DulajBopitiya/Nemesis-Micro-mouse-/Nemisis Firmware/Core/Src/main.c

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
/* Includes ------------------------------------------------------------------*/
#include "main.h"

/* USER CODE BEGIN Includes */
#include "ws2812.h"
#include "buzzer.h"
#include "dbg.h"
#include "icm42688.h"
#include "max17049.h"
#include "motor.h"
#include "as5047p.h"
#include "battery.h"
#include "console.h"
#include "sensors.h"
#include "launcher.h"
#include "control.h"
#include "solver.h"
#include "mazestore.h"
/* USER CODE END Includes */

ADC_HandleTypeDef hadc1;
ADC_HandleTypeDef hadc4;

I2C_HandleTypeDef hi2c3;

QSPI_HandleTypeDef hqspi1;

SPI_HandleTypeDef hspi1;
SPI_HandleTypeDef hspi3;

TIM_HandleTypeDef htim1;
TIM_HandleTypeDef htim2;
TIM_HandleTypeDef htim3;
TIM_HandleTypeDef htim8;
TIM_HandleTypeDef htim15;
DMA_HandleTypeDef hdma_tim15_ch1;

UART_HandleTypeDef huart1;

void SystemClock_Config(void);
static void MX_GPIO_Init(void);
static void MX_DMA_Init(void);
static void MX_TIM15_Init(void);
static void MX_SPI1_Init(void);
static void MX_I2C3_Init(void);
static void MX_ADC4_Init(void);
static void MX_SPI3_Init(void);
static void MX_TIM1_Init(void);
static void MX_TIM2_Init(void);
static void MX_ADC1_Init(void);
static void MX_TIM8_Init(void);
static void MX_USART1_UART_Init(void);
static void MX_TIM3_Init(void);
static void MX_QUADSPI1_Init(void);
/* USER CODE BEGIN 0 */

/* ====================== IR reflectance sensors ========================
   6 emitter/receiver pairs. Naming: side (LEFT/RIGHT) + position
   (LM = left-most, M = middle, FRONT). Emitters are GPIO outputs that drive
   an IR LED through a MOSFET (active-HIGH). Receivers are phototransistors
   read by an ADC.

   Receiver -> ADC mapping (from main.h pins / CubeMX MSP comments):
     RIGHT_RM    PB12 -> ADC4_IN3   (hadc4)
     LEFT_LM     PA0  -> ADC1_IN1   \
     RIGHT_M     PA3  -> ADC1_IN4    |
     RIGHT_FRONT PC1  -> ADC1_IN7    >  ADC1 (hadc1), configured in CubeMX
     LEFT_FRONT  PC2  -> ADC1_IN8    |
     LEFT_M      PC3  -> ADC1_IN9   /
   ====================================================================== */

#define IR_AVG_SAMPLES  16U     /* conversions averaged per phase (noise floor) */

/* Average N single conversions of one channel on the given ADC. Reconfigures
   the channel each call so one ADC can be shared across several inputs. */
static uint16_t ADC_ReadAvg(ADC_HandleTypeDef *adc, uint32_t channel, uint32_t n)
{
  ADC_ChannelConfTypeDef c = {0};
  c.Channel      = channel;
  c.Rank         = ADC_REGULAR_RANK_1;
  c.SamplingTime = ADC_SAMPLETIME_640CYCLES_5;  /* high-Z phototransistor node */
  c.SingleDiff   = ADC_SINGLE_ENDED;
  c.OffsetNumber = ADC_OFFSET_NONE;
  c.Offset       = 0;
  HAL_ADC_ConfigChannel(adc, &c);

  uint32_t acc = 0;
  for (uint32_t i = 0; i < n; i++)
  {
    HAL_ADC_Start(adc);
    HAL_ADC_PollForConversion(adc, 10);
    acc += HAL_ADC_GetValue(adc);
    HAL_ADC_Stop(adc);
  }
  return (uint16_t)(acc / n);
}

/* One IR sensor: its emitter GPIO + the ADC + channel its receiver sits on. */
typedef struct
{
  const char        *name;
  GPIO_TypeDef      *em_port;
  uint16_t           em_pin;
  ADC_HandleTypeDef *adc;
  uint32_t           channel;
} IR_Sensor;

#define IR_COUNT 6
static const IR_Sensor ir_sensors[IR_COUNT] =
{
  { "L_LM", LEFT_LM_EMMITER_GPIO_Port,     LEFT_LM_EMMITER_Pin,     &hadc1, ADC_CHANNEL_1 }, /* recv PA0=ADC1_IN1 */
  { "L_M",  LEFT_M_EMMITER_GPIO_Port,      LEFT_M_EMMITER_Pin,      &hadc1, ADC_CHANNEL_9 }, /* recv PC3=ADC1_IN9 */
  { "L_F",  LEFT_FRONT_EMMITER_GPIO_Port,  LEFT_FRONT_EMMITER_Pin,  &hadc1, ADC_CHANNEL_8 }, /* recv PC2=ADC1_IN8 */
  { "R_F",  RIGHT_FRONT_EMMITER_GPIO_Port, RIGHT_FRONT_EMMITER_Pin, &hadc1, ADC_CHANNEL_7 }, /* recv PC1=ADC1_IN7 */
  { "R_M",  RIGHT_M_EMMITER_GPIO_Port,     RIGHT_M_EMMITER_Pin,     &hadc1, ADC_CHANNEL_4 }, /* recv PA3=ADC1_IN4 */
  { "R_RM", RIGHT_RM_EMMITER_GPIO_Port,    RIGHT_RM_EMMITER_Pin,    &hadc4,    ADC_CHANNEL_3 }, /* recv PB12=ADC4_IN3 */
};

/* Reflective read of one sensor: emitter OFF (ambient) then ON (ambient + IR);
   reflected = lit - ambient. Only one emitter is ever on at a time, so there's
   no optical crosstalk between sensors. Emitter assumed active-HIGH. */
static void IR_Read(const IR_Sensor *s, uint16_t *amb, uint16_t *lit)
{
  HAL_GPIO_WritePin(s->em_port, s->em_pin, GPIO_PIN_RESET);
  HAL_Delay(1);
  *amb = ADC_ReadAvg(s->adc, s->channel, IR_AVG_SAMPLES);

  HAL_GPIO_WritePin(s->em_port, s->em_pin, GPIO_PIN_SET);
  HAL_Delay(1);                                   /* let LED + receiver settle */
  *lit = ADC_ReadAvg(s->adc, s->channel, IR_AVG_SAMPLES);

  HAL_GPIO_WritePin(s->em_port, s->em_pin, GPIO_PIN_RESET);
}

/* USER CODE END 0 */

/**
  * @brief  The application entry point.
  * @retval int
  */
int main(void)
{

  /* USER CODE BEGIN 1 */
#ifdef APP_VTOR_BASE
  /* OTA-relocated build (env:app_ota): the app lives at 0x08008000, reached via
     the bootloader. Point the vector table at the app base HERE, before HAL_Init
     enables SysTick or any IRQ - unambiguous and independent of the framework's
     fragile VECT_TAB_OFFSET macro. (The bootloader also sets VTOR before the
     jump; this makes the app self-correct regardless of how it was entered.) */
  SCB->VTOR = (uint32_t)(APP_VTOR_BASE);
#endif
  uint32_t last_led = 0;     /* heartbeat LED scheduler */
  uint8_t  led_step = 0;
  uint32_t last_sens = 0;    /* IR sensor sweep scheduler (~100 Hz) */
  /* USER CODE END 1 */

  /* MCU Configuration--------------------------------------------------------*/

  /* Reset of all peripherals, Initializes the Flash interface and the Systick. */
  HAL_Init();

  /* Configure the system clock */
  SystemClock_Config();

  /* Initialize all configured peripherals */
  MX_GPIO_Init();
  MX_DMA_Init();
  MX_TIM15_Init();
  MX_SPI1_Init();
  MX_I2C3_Init();
  MX_ADC4_Init();
  MX_SPI3_Init();
  MX_TIM1_Init();
  MX_TIM2_Init();
  MX_ADC1_Init();
  MX_TIM8_Init();
  MX_USART1_UART_Init();
  MX_TIM3_Init();
  MX_QUADSPI1_Init();
  /* USER CODE BEGIN 2 */
  DBG_Init();
  LOG("\r\n=== Nemisis boot ===\r\n");
  LOG("build: " __DATE__ " " __TIME__ "\r\n");   /* prove which binary is running */

  /* --- Persistent maze / speed-run memory (internal flash) --------------
     Reads the reset cause FIRST (before anything clears the flags): a cold
     power-on / battery swap KEEPS the last saved run, a warm NRST-button reset
     ERASES it. Then loads any saved map so a long-press fast run is available
     after a power cycle. Must run before the launcher/solver use the map. */
  MazeStore_Init();

  /* Recompute SystemCoreClock straight from the RCC registers, then dump the
     actual PLL config so we can see what the silicon is really doing. */
  SystemCoreClockUpdate();
  LOG("SYSCLK = %lu Hz  (HSE_VALUE=%lu)\r\n",
      (unsigned long)SystemCoreClock, (unsigned long)HSE_VALUE);
  LOG("PLLCFGR=0x%08lX  PLLM=%lu PLLN=%lu PLLR=%lu\r\n",
      (unsigned long)RCC->PLLCFGR,
      (unsigned long)(((RCC->PLLCFGR & RCC_PLLCFGR_PLLM) >> RCC_PLLCFGR_PLLM_Pos) + 1U),
      (unsigned long)((RCC->PLLCFGR & RCC_PLLCFGR_PLLN) >> RCC_PLLCFGR_PLLN_Pos),
      (unsigned long)((((RCC->PLLCFGR & RCC_PLLCFGR_PLLR) >> RCC_PLLCFGR_PLLR_Pos) + 1U) * 2U));
  LOG("CR=0x%08lX  HSERDY=%lu PLLRDY=%lu  CFGR_SWS=%lu (3=PLL)\r\n",
      (unsigned long)RCC->CR,
      (unsigned long)((RCC->CR & RCC_CR_HSERDY) ? 1U : 0U),
      (unsigned long)((RCC->CR & RCC_CR_PLLRDY) ? 1U : 0U),
      (unsigned long)((RCC->CFGR & RCC_CFGR_SWS) >> RCC_CFGR_SWS_Pos));

  Buzzer_Init();
  WS2812_Init(&htim15, TIM_CHANNEL_1);

  /* cool power-on chime */
  Buzzer_StartupSound();

  /* --- ICM-42688-P IMU bring-up check (SPI1) ---------------------------- */
  bool imu_ok = ICM42688_Init(&hspi1);       /* soft reset + WHO_AM_I + power on */
  uint8_t imu_who = ICM42688_ReadReg(&hspi1, 0x75);  /* read it back for the log */
  LOG("IMU WHO_AM_I = 0x%02X (expect 0x%02X) -> %s\r\n",
      imu_who, ICM42688_WHOAMI,
      imu_ok ? "OK" : "FAILED (check wiring/CS/SPI cfg)");

  /* --- I2C3 bus scan (diagnostic): list every 7-bit address that ACKs --- */
  LOG("I2C3 scan:");
  uint8_t found = 0;
  for (uint8_t a = 1; a < 128; a++)
  {
    if (HAL_I2C_IsDeviceReady(&hi2c3, (uint16_t)(a << 1), 2, 5) == HAL_OK)
    {
      LOG(" 0x%02X", a);
      found++;
    }
  }
  LOG("  (%u device(s))\r\n", found);

  /* --- MAX17049 fuel gauge bring-up check (I2C3) ------------------------ */
  bool fuel_ok = MAX17049_Probe(&hi2c3);
  if (fuel_ok)
  {
    MAX17049_Status s;
    MAX17049_ReadStatus(&hi2c3, &s);
    LOG("FUEL ver=0x%04X  pack=%ld mV  soc=%ld.%02ld %%  rate=%ld m%%/hr -> OK\r\n",
        s.version, (long)(s.pack_v * 1000.0f),
        (long)s.soc, (long)((s.soc - (long)s.soc) * 100.0f),
        (long)(s.crate * 1000.0f));
  }
  else
  {
    LOG("FUEL gauge: NO ACK (check I2C3 wiring / pull-ups / battery)\r\n");
  }

  /* --- AS5047P encoders bring-up check (shared SPI3, separate CS) -------
     Both encoders sit on SPI3; left CS=PA4, right CS=PB2. Each read pulses
     only its own CS, so they coexist on the one bus. */
  AS5047P_Handle encL, encR;
  AS5047P_Init(&encL, &hspi3, ENCODERL_CS_GPIO_Port, ENCODERL_CS_Pin);
  AS5047P_Init(&encR, &hspi3, ENCODERR_CS_GPIO_Port, ENCODERR_CS_Pin);
  bool encL_ok = AS5047P_Probe(&encL);
  bool encR_ok = AS5047P_Probe(&encR);
  LOG("ENCODERL raw=%u -> %s\r\n", AS5047P_ReadAngleRaw(&encL),
      encL_ok ? "OK" : "bad frame (check CS PA4 / MISO / power)");
  LOG("ENCODERR raw=%u -> %s\r\n", AS5047P_ReadAngleRaw(&encR),
      encR_ok ? "OK" : "bad frame (check CS PB2 / MISO / power)");

  /* ABI quadrature cross-check: left A/B (PC0/PA9) -> TIM1, right A/B
     (PA1/PA5) -> TIM2. Start both counters from zero. */
  HAL_TIM_Encoder_Start(&htim1, TIM_CHANNEL_ALL);
  HAL_TIM_Encoder_Start(&htim2, TIM_CHANNEL_ALL);
  __HAL_TIM_SET_COUNTER(&htim1, 0);
  __HAL_TIM_SET_COUNTER(&htim2, 0);

  /* --- All 6 IR reflectance sensors bring-up --------------------------
     Calibrate both ADCs (ADC4 for RIGHT_RM, ADC1 for the other five), then do
     one reflective read of each. With nothing in front 'refl' is small; bring
     a hand/wall close to a given sensor and only that one's 'refl' should jump. */
  HAL_ADCEx_Calibration_Start(&hadc4, ADC_SINGLE_ENDED);
  HAL_ADCEx_Calibration_Start(&hadc1, ADC_SINGLE_ENDED);
  for (int i = 0; i < IR_COUNT; i++)
  {
    uint16_t amb, lit;
    IR_Read(&ir_sensors[i], &amb, &lit);
    int delta = (int)lit - (int)amb;
    LOG("IR %-4s: ambient=%4u lit=%4u reflected=%5d -> %s\r\n",
        ir_sensors[i].name, amb, lit, delta,
        (delta > 20 || delta < -20) ? "responding" : "weak/none (check wiring/polarity)");
  }

  /* --- Vacuum fan bring-up (PB9 = TIM8_CH3 PWM, MOSFET-driven) ----------
     TIM8 is an advanced timer, so HAL_TIM_PWM_Start also flips the main output
     enable (MOE) for us. Period=65535, so CCR = duty% * 65535 / 100. Start at
     0% (fan off) and ramp it in the loop below so you can hear/feel each step.
     WARNING: secure the robot - the fan pulls air hard at 100%. */
  HAL_TIM_PWM_Start(&htim8, TIM_CHANNEL_3);
  __HAL_TIM_SET_COMPARE(&htim8, TIM_CHANNEL_3, 0);
  LOG("VACUUM FAN on PB9 (TIM8_CH3) ready - ramping 0/25/50/75/100%% in loop\r\n");

  LOG("init done\r\n");

  /* --- DRV8874 motor movement test (M1: PC8/PC7, M2: PC6/PB7) -----------
     Runs ONCE at boot: both forward, both reverse, pivot one way, pivot the
     other, then stops. WARNING: the robot WILL drive - put it on a stand or
     in clear space first. 3 s grace delay below so you can let go. Watch RTT
     for the per-phase current sense. Set this #if to 0 once verified. */
/* Motors are now driven interactively from the console ('motor ...' /
   'motor test'); the old auto-drive-at-boot is disabled for safety. */
#if 0
  Motor_TestInit(&hadc4);
  LOG("MOTOR demo starting in 3 s - clear the bench / put on stand...\r\n");
  HAL_Delay(3000);
  Motor_DriveSequence(&hadc4);
#endif

  /* --- Interactive debug console (RTT + USART1->ESP32) ------------------
     Type 'help' over J-Link RTT Viewer (or the ESP32/WiFi link) to drive any
     subsystem on demand. This replaces the old fixed demo loop. */
  ConsoleCtx con = {
    .hspi_imu  = &hspi1,
    .hspi_enc  = &hspi3,
    .hi2c_fuel = &hi2c3,
    .hadc1     = &hadc1,
    .hadc4     = &hadc4,
    .htim_fan  = &htim8,
    .htim_mot  = &htim3,
    .htim_encL = &htim1,
    .htim_encR = &htim2,
    .huart     = &huart1,
    .hqspi     = &hqspi1,
  };
  Console_Init(&con);

  /* --- Battery safety monitor (MAX17049 on I2C3) -----------------------
     Watches pack voltage; blocks + kills motors/vacuum when CRITICAL and
     signals state on the RGB LED + buzzer. Voltage-based, not SOC-based.
     Must come after WS2812/Buzzer init and the fan PWM start. */
  Battery_Init(&hi2c3, &htim8, TIM_CHANNEL_3);
  LOG("BATTERY monitor armed (crit<%umV low<%umV) - state=%s\r\n",
      (unsigned)BATTERY_CRIT_MV, (unsigned)BATTERY_LOW_MV,
      Battery_StateName(Battery_State()));

  /* --- IR wall sensors (6x reflectance on ADC1/ADC4) -------------------
     Acquisition layer for wall detection + corridor centring. Swept from the
     main loop below (~100 Hz); ADCs are already calibrated in Console_Init. */
  Sensors_Init(&hadc1, &hadc4);
  Sensors_CalLoad();                 /* restore wall-sensor calibration from flash */
  LOG("SENSORS armed (6x IR, ~100 Hz sweep) - 'walls' to view\r\n");

  /* --- Offline race-start launcher (button PD2 + front-sensor gesture) ---
     Press the button to go fully offline (mutes the WiFi link so it can't jitter
     the loop), wave a hand over the two front sensors to arm, 3 s countdown, then
     it runs the solve with no app attached. Button again = cancel/abort. */
  Launcher_Init();
  LOG("LAUNCHER ready - press button for offline run (hand over front IR to go)\r\n");
  /* USER CODE END 2 */

  /* Infinite loop */
  /* USER CODE BEGIN WHILE */
  while (1)
  {
    /* USER CODE END WHILE */

    /* USER CODE BEGIN 3 */
    /* Non-blocking: parse any command from RTT/USART1 and stream live samples
       for whichever subsystem is active. All interactive debug lives here. */
    Console_Task();

    /* IR wall-sensor sweep at ~200 Hz (every 5 ms). Polling for now; the 1 kHz
       control loop preempts it so its timing is unaffected. (Restored to 200 Hz
       for lower centring lag now that the boot hang - a UART TX-ring deadlock,
       unrelated to the sweep rate - is fixed. ~4 mm lag at mapping speed. The
       real low-lag fix is still the DMA transport swap for the speed run - see
       the navigator-cell-motion / ir-wall-sensors notes / fast-run-dma reminder.) */
    /* Speed-adaptive IR: faster sweep (fewer samples) + more often when moving
       fast, to cut the position lag that makes fast runs drift; clean + 5 ms when
       slow/stationary. */
    float wcps = Control_GetWheelSpeedCps();
    Sensors_AdaptTiming(wcps);
    /* Drop to the 3 ms (effectively back-to-back) sweep rate from 6000 cps so the
       8000 cps SEARCH speed also gets the fresher reads on a cell approach - cuts
       front-wall detection latency (~5->3 ms) so the front-stop brakes sooner and
       stops bumping walls. Per-read timing is unchanged (AdaptTiming stays off),
       so the readings still match the stationary calibration. */
    uint32_t sweep_ms = (wcps > 6000.0f) ? 3U : 5U;
    if ((HAL_GetTick() - last_sens) >= sweep_ms)
    {
      last_sens = HAL_GetTick();
      Sensors_Update();               /* blocking sweep (no-op when async is on)   */
    }
    /* Non-blocking background sweep: pumped EVERY pass (ungated). Owns the sweep
       when 'irasync on', else returns immediately. This is the DMA-alternative -
       it frees the ~3.4 ms the blocking sweep spins without any DMA/timer/IRQ. */
    Sensors_Pump();

    /* Battery safety: poll the gauge, run the cut-off FSM, drive the LED/buzzer
       warning. Owns the RGB LED whenever the pack isn't healthy. */
    Battery_Task();

    /* Offline race-start sequencer: button -> mute WiFi -> hand gesture ->
       countdown -> solve. Owns the LEDs while armed/counting/running. */
    Launcher_Task();

    /* Heartbeat: cycle the RGB LED dimly once a second so you can see the
       firmware is alive without spamming the console. Skipped while the battery
       monitor owns the LED (LOW/CRITICAL) or the offline launcher owns it. */
    if (Battery_State() == BATT_OK && !Launcher_Active() &&
        (HAL_GetTick() - last_led) >= 1000U)
    {
      last_led = HAL_GetTick();
      switch (led_step)
      {
        case 0:  WS2812_SetAll(8, 0, 0); break;   /* red   */
        case 1:  WS2812_SetAll(0, 8, 0); break;   /* green */
        default: WS2812_SetAll(0, 0, 8); break;   /* blue  */
      }
      WS2812_Show();
      led_step = (led_step + 1U) % 3U;
    }
  }
  /* USER CODE END 3 */
}

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
