DulajBopitiya/Nemesis-Micro-mouse-/Nemisis Firmware/NEMSIS.ioc

Mcu.UserName=STM32G474RETx
PA0.GPIO_Label=LEFT_LM_RECEIVER
PA0.Signal=ADC1_IN1
PA1.GPIO_Label=ENCODERR_A
PA1.Signal=S_TIM2_CH2
PA10.GPIO_Label=RIGHT_M_EMMITER
PA10.Signal=GPIO_Output
PA13.Signal=SYS_JTMS-SWDIO
PA14.Signal=SYS_JTCK-SWCLK
PA15.Signal=SPI1_NSS
PA2.GPIO_Label=RGB_LED
PA2.Signal=S_TIM15_CH1
PA3.GPIO_Label=RIGHT_M_RECEIVER
PA3.Signal=ADC1_IN4
PA4.GPIO_Label=ENCODERL_CS
PA4.Signal=GPIO_Output
PA5.GPIO_Label=ENCODERR_B
PA5.Signal=S_TIM2_CH1
PA6.Signal=QUADSPI1_BK1_IO3
PA7.Signal=QUADSPI1_BK1_IO2
PA8.GPIO_Label=FUEL_SCL
PA8.Signal=I2C3_SCL
PA9.GPIO_Label=ENCODERL_B
PA9.Signal=S_TIM1_CH2
PB0.Signal=QUADSPI1_BK1_IO1
PB1.Signal=QUADSPI1_BK1_IO0
PB10.Signal=QUADSPI1_CLK
PB11.Signal=QUADSPI1_BK1_NCS
PB12.GPIO_Label=RIGHT_RM_RECEIVER
PB12.Signal=GPIO_Analog
PB13.GPIO_Label=RIGHT_RM_EMMITER
PB13.Signal=GPIO_Output
PB14.GPIO_Label=M2_CURRENT_SENSE
PB14.Signal=ADC4_IN4
PB15.GPIO_Label=M1_CURRENT_SENSE
PB15.Signal=ADC4_IN5
PB2.GPIO_Label=ENCODERR_CS
PB2.Signal=GPIO_Output
PB3.Signal=SPI1_SCK
PB4.Signal=SPI1_MISO
PB5.Signal=SPI1_MOSI
PB6.GPIO_Label=RIGHT_FRONT_EMMITER
PB6.Signal=GPIO_Output
PB7.GPIO_Label=M2_IN2
PB7.Signal=S_TIM3_CH4
PB8-BOOT0.GPIO_Label=BUZZER
PB8-BOOT0.Signal=GPIO_Output
PB9.GPIO_Label=VACCUM_FAN
PB9.Signal=S_TIM8_CH3
PC0.GPIO_Label=ENCODERL_A
PC0.Signal=S_TIM1_CH1
PC1.GPIO_Label=RIGHT_FRONT_RECEIVER
PC1.Signal=ADC1_IN7
PC10.GPIO_Label=ENCODER_SCK
PC10.Signal=SPI3_SCK
PC11.GPIO_Label=ENCODER_MISO
PC11.Signal=SPI3_MISO
PC12.GPIO_Label=ENCODER_MOSI
PC12.Signal=SPI3_MOSI
PC13.GPIO_Label=LEFT_FRONT_EMMITER
PC13.Signal=GPIO_Output
PC14-OSC32_IN.GPIO_Label=LEFT_M_EMMITER
PC14-OSC32_IN.Signal=GPIO_Output
PC15-OSC32_OUT.GPIO_Label=LEFT_LM_EMMITER
PC15-OSC32_OUT.Signal=GPIO_Output
PC2.GPIO_Label=LEFT_FRONT_RECEIVER
PC2.Signal=ADC1_IN8
PC3.GPIO_Label=LEFT_M_RECEIVER
PC3.Signal=ADC1_IN9
PC4.Signal=USART1_TX
PC5.Signal=USART1_RX
PC6.GPIO_Label=M2_IN1
PC6.Signal=S_TIM3_CH1
PC7.GPIO_Label=M1_IN2
PC7.Signal=S_TIM3_CH2
PC8.GPIO_Label=M1_IN1
PC8.Signal=S_TIM3_CH3
PC9.GPIO_Label=FUEL_SDA
PC9.Signal=I2C3_SDA
PD2.GPIO_Label=BUTTON
PD2.Signal=GPIO_Input
PF0-OSC_IN.Signal=RCC_OSC_IN
PF1-OSC_OUT.Signal=RCC_OSC_OUT
