DulajBopitiya/Nemesis-Micro-mouse-/(commit log)

2026-07-06 Initial commit: NEMESIS micromouse — firmware, ESP32-C3 bridge, debug app
    Whole-project monorepo:
    · Nemisis Firmware/ STM32G474 firmware (PlatformIO + CubeMX)
    · Nemisis ESP32C3/ WiFi<->UART bridge + captive provisioning
    · NEMISIS PYTHON DEBUG APPLICATION/ PySide6 live tuning cockpit
    Adds project README + .gitignore (excludes .pio, .venv, __pycache__, logs).
2026-07-07 ota: cap app flash region to protect persistent pages (step 1)
    Reserve the top 12 KB of flash (maze/cal/settings @ 0x0807D000+) from the
    app linker region so code can never grow over the persistent data that
    MazeStore_Save/settings/sensors erase from top-of-flash.
    Key gotcha: PlatformIO's stm32cube builder does NOT use STM32CubeIDE/*.ld;
    it selects tool-ldscripts-ststm32/stm32g4/STM32G474RETX_FLASH.ld from the
    package dir (wiped on package update). So the fix that actually takes effect:
    - add in-repo linker/STM32G474RETX_FLASH.ld (copy of the package default)
    with FLASH LENGTH capped 512K -> 500K
    - point board_build.ldscript at it in platformio.ini
    STM32CubeIDE/*.ld capped too for consist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
2026-07-07 ota: add QUADSPI1 for W25Q32JW external flash (CubeMX regen, step 2)
    Enable QUADSPI1 (Bank 1, quad lines) for the on-board W25Q32JW 32 Mbit
    NOR flash that will stage OTA images. Pins PA6/PA7 (IO3/IO2), PB0/PB1
    (IO1/IO0), PB10 (CLK), PB11 (NCS) at AF10, VERY_HIGH speed. Init: prescaler
    3 (~40 MHz start), FlashSize 21 (4 MB), CS-high 6 cyc, clock mode 0.
    Regen reconciliation (hand-edits CubeMX wiped, restored here):
    - ADC1 + ADC4 hardware oversampler (8x, 3-bit shift; IR-acq Increment A)
    was stripped back to OversamplingMode=DISABLE -> re-applied.
    Verified preserved: SPI1 8-bit/1EDGE + PA15 CS (IMU), SPI3 8-bit/2EDGE
    mode-1 (encoders), HSE 24 MHz. Builds clean (Flash 21.8%). QUADSPI not yet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
2026-07-07 ota: W25Q32JW QSPI driver + qspi console cmd (step 2 bus proven)
    lib/qspiflash: single-line (1-1-1) indirect-mode driver for the OTA-staging
    NOR flash - JEDEC id, status, read, 4KB/chip erase, page-aligned program.
    All blocking, all range-checked. Quad-speed read is a later optimisation.
    console: boot probe prints the chip status; `qspi [id|status|read|test]`
    command, where `qspi test` does a destructive erase/program/verify round-
    trip on the last 4KB sector (scratch, never an OTA slot).
    Bench-verified over the WiFi link (app -> ESP32-C3 -> UART -> STM32 -> QSPI):
    qspi id -> mfr=0xEF type=0x60 cap=0x16 Winbond W25Q32 (4 MB) OK
    qspi test -> PASS erase/program/read round-trip OK
    The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
2026-07-07 ota: Tier A - firmware transport + QSPI staging (bench-proven over WiFi)
    Stream a firmware .bin from the app into the mouse's external QSPI flash and
    CRC-verify it there. No jump/flash of the running app - staging only, so it
    cannot brick the board. First half of the OTA workflow; the bootloader that
    copies a verified image into the internal app slot is Tier B.
    Firmware:
    - lib/ota: staging module - QSPI slot map, zlib CRC-32, on-the-fly sector
    erase (each erase hides behind its chunk's ACK, no long pre-READY stall),
    read-back CRC verify, metadata record. Ota_Begin/Write/Finish + verify.
    - console: `otarx <size> <crc32>` receiver (base64 payload so it can never
    contain the ESP bridge's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
    [connection.py, gui.py, ota_upload.py]
2026-07-07 ota: Tier B / B1 - app relocation + jump-only bootloader (HW-proven)
    De-risks the two scary unknowns of the OTA project: does the app run (a)
    relocated to a non-zero flash offset and (b) reached via a bootloader jump.
    Both now proven on hardware - full console menu + sensors work.
    Flash map: bootloader 0x08000000 (32K) | app 0x08008000 (468K) | persistent
    0x0807D000 (12K, untouched).
    - bootloader/: standalone PlatformIO project (env:boot, boot.ld). B1 = jump
    only: validate the app's vector (SP in RAM) and branch. Never OTA'd.
    - linker/app_reloc.ld + env:app_ota: same firmware based at 0x08008000.
    - main.c: explicit SCB->VTOR = APP_VTOR_BASE in USER CODE BEGIN 1 (guarded, so
    the normal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
2026-07-07 ota: Tier B / B2 - the installer; OTA functionally complete (HW-proven)
    `ota apply` now installs a staged image over the air end to end:
    app: ota apply -> Ota_VerifyIncoming() -> set TAMP BKP0R apply flag -> reset
    bootloader: if flag set + QSPI image CRC-valid -> erase app slot -> copy
    QSPI incoming image -> internal 0x08008000 (doubleword program, DBANK-aware
    geometry like lib/mazestore) -> verify copy CRC -> clear flag -> jump.
    Bootloader grew from jump-only: HAL_Init (HSI ~16MHz), QSPI bring-up (mirrors
    lib/qspiflash single-line read; own HAL_QSPI_MspInit), internal-flash program,
    CRC-32 (matches Ota_Crc32). Own hal_conf (QSPI+FLASH enabled). Single-slot: a
    power loss mid-cop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
    [gui.py, main.c]
2026-07-07 ota: LED feedback, one-click install, and boot-confirm flash
    UX polish now that the OTA pipeline is proven end to end.
    Firmware (4 RGB LEDs, WS2812 on PA2):
    - During `otarx` receive: LEDs fill blue, one per ~25% of the image (live
    progress); solid green when the staged image verifies, solid red on any
    failure (held ~1.5 s so it's visible before the heartbeat resumes). Safe
    because the whole transfer runs inside the blocking command.
    - First boot after an install: the bootloader writes OTA_APPLIED_MAGIC to TAMP
    BKP1R on a successful copy; the app reads+clears it (Ota_JustApplied) and
    flashes the LEDs green ("update installed and running").
    App:
    - After staging verifies, prompt "In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
    [gui.py, main.c]
2026-07-07 ota(app): one-click "Build & push" firmware button
    Removes the "did I build the right env?" footgun. Build & push runs
    `pio run -e app_ota` in a worker thread (streaming PlatformIO output to the
    console log), and on success stages + offers to install the freshly built
    firmware.bin - so the app always pushes exactly what it just built.
    Refactored the staging flow out of _ota_clicked into _ota_stage_path, shared by
    both Build & push and the existing Update firmware… (pick-a-.bin) button. pio
    is resolved from the standard penv location with a PATH fallback.
    [gui.py]
2026-07-07 ota: B3.1 - golden image + manual rollback
    Keep a known-good "golden" firmware in QSPI to fall back to.
    - lib/ota: Ota_PromoteGolden (copy incoming QSPI slot -> golden slot + meta,
    only if incoming CRC-verifies), Ota_GoldenValid, Ota_RequestRollback (sets
    the apply flag to OTA_ROLLBACK_MAGIC).
    - console: `ota golden` (save running/staged image as golden) and
    `ota rollback` (reset into bootloader to restore golden).
    - bootloader: install_from(slot,meta) generalised (incoming or golden);
    do_apply now auto-restores golden if the incoming copy fails midway
    (best-effort rescue); do_rollback restores golden on the ROLLBACK flag.
    App: "Recovery ▾" toolbar menu - Save running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
    [gui.py, main.c]
2026-07-07 ota: B3.2 - automatic boot-time CRC gate (power-loss-safe)
    Closes the power-loss-during-copy window: a partial app image can no longer
    strand the board. On EVERY boot the bootloader validates the app slot and
    auto-restores golden if it's bad.
    Bootloader:
    - Added a QSPI write path (write-enable / sector-erase / page-program / WIP
    poll) for the current-app metadata sector (QSPI 0x0E0000).
    - install_meta() records size+crc of what it just wrote as the "current" image.
    do_apply / do_rollback go through it, so current-meta always reflects the app
    slot after any install.
    - validate_and_recover() runs every boot: if current-meta is valid and the app
    slot CRC no longer matches it (partial c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
    [main.c]
2026-07-07 control: fix turn under-rotate drift via heading carry (hcarry)
    Root cause (pinned in control.c): Control_Start re-zeros heading_deg on
    every primitive, so a snappy pivot that releases ~2 deg short hands the next
    segment a skewed heading it adopts as "straight ahead" - the ~8-11 deg
    cumulative under-rotate seen across the 21 fast-run logs (analyze_drift).
    Fix: carry the residual (heading_deg - head_target) into the next mid-run
    segment instead of zeroing; head_setpoint stays 0 so that segment rotates the
    debt back out while moving rather than banking the skew. Scoped to auto-runs
    (seq_skip_gyro_cal), captured at the pivot completion (covers plain pivots +
    flow-turn pivot-finish), cleared at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
    [analyze_turns.py, protocol.py]
2026-07-07 docs(control): map the move/finish/stall/front-stop state machine (P4 #1)
    Read-only map of control.c's motion state machine as the foundation for the
    P4 cleanup: two exec contexts (1 kHz ISR vs main-loop tasks), the ISR pipeline
    order, all mode flags + sub-mode owners, the move/arc/pivot blocks, the
    done-flag handshake, and Control_Stop as the single teardown funnel. Section 7
    is a cleanup checklist for P4 #2 (front-wall reads fragmented across 5
    predicates, two copy-paste stall guards, the 3-way finish predicate,
    bench-only toggles to confirm). No behaviour change.
    Also checks off P2 (sim stats 16x16: worst_us=1182, reached/optimal 30/30) and
    the P3/P4 bench-verify TODO lines.
    Co-Authored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
